phamhungcrab/IT4210/docs/images/4.2.png

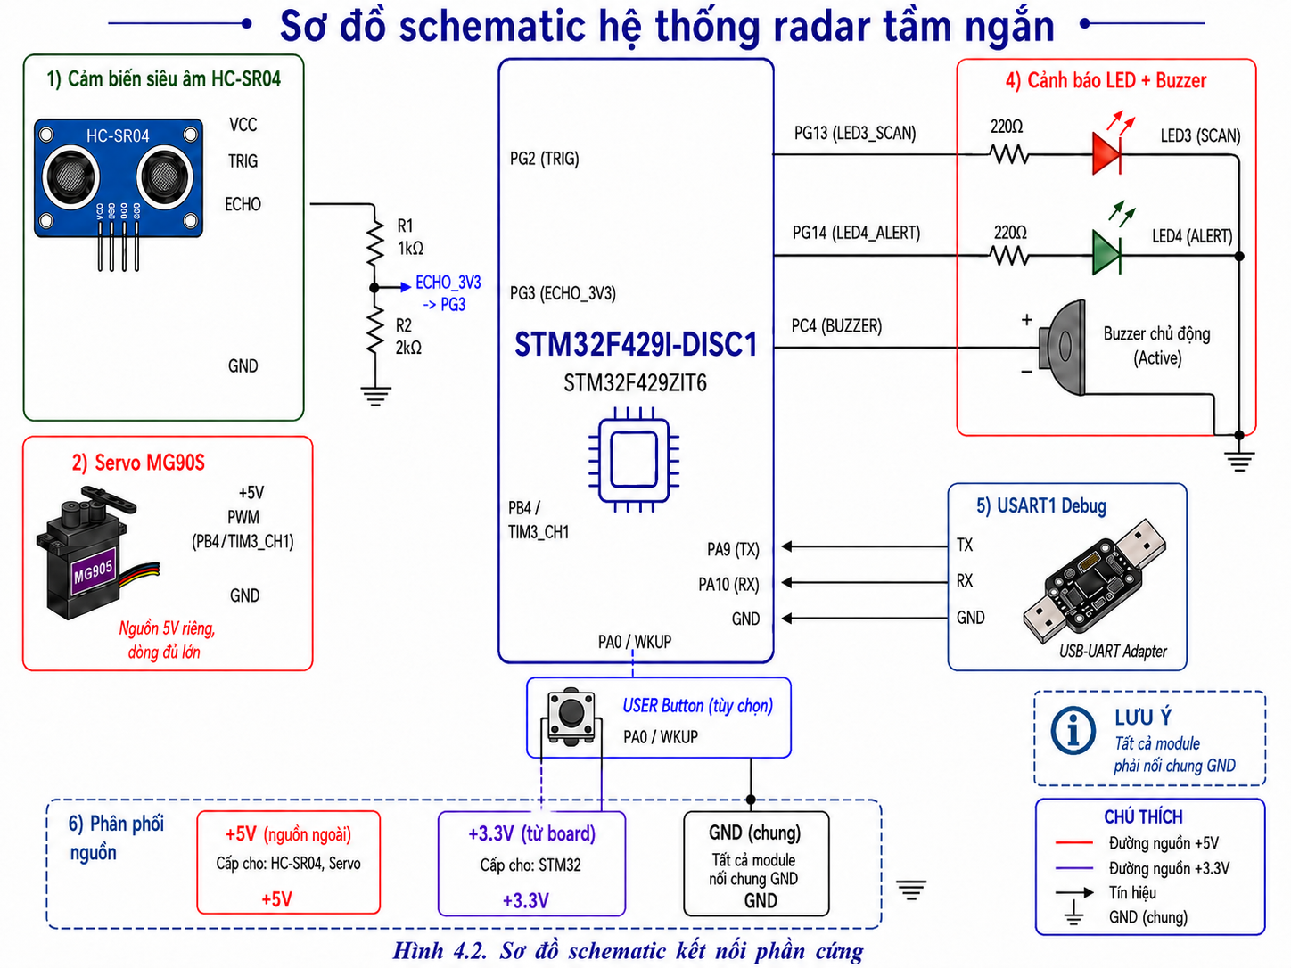
docs/images/4.2.png
