phamhungcrab/IT4210/radar_short_range_touchgfx/Core/Inc/main.h

#define VSYNC_FREQ_Pin GPIO_PIN_2
#define VSYNC_FREQ_GPIO_Port GPIOE
#define RENDER_TIME_Pin GPIO_PIN_3
#define RENDER_TIME_GPIO_Port GPIOE
#define FRAME_RATE_Pin GPIO_PIN_4
#define FRAME_RATE_GPIO_Port GPIOE
#define MCU_ACTIVE_Pin GPIO_PIN_5
#define MCU_ACTIVE_GPIO_Port GPIOE
#define SPI5_NCS_Pin GPIO_PIN_1
#define SPI5_NCS_GPIO_Port GPIOC
#define B1_USER_Pin GPIO_PIN_0
#define B1_USER_GPIO_Port GPIOA
#define HCSR04_TRIG_Pin GPIO_PIN_2
#define HCSR04_TRIG_GPIO_Port GPIOA
#define BUZZER_Pin GPIO_PIN_4
#define BUZZER_GPIO_Port GPIOC
#define LED3_SCAN_Pin GPIO_PIN_13
#define LED3_SCAN_GPIO_Port GPIOG
#define LED4_ALERT_Pin GPIO_PIN_14
#define LED4_ALERT_GPIO_Port GPIOG
