phamhungcrab/IT4210/radar_short_range_touchgfx/STM32CubeIDE/Application/User/buzzer_led.c

#include "buzzer_led.h"
#include "main.h"

/*
 * BUZZER: PC4
 * LED3_SCAN: PG13
 * LED4_ALERT: PG14
 */

void BuzzerLed_Init(void)
{
    Buzzer_Set(0);
    LedScan_Set(0);
    LedAlert_Set(0);
}

void Buzzer_Set(uint8_t on)
{
    HAL_GPIO_WritePin(BUZZER_GPIO_Port,
                      BUZZER_Pin,
                      on ? GPIO_PIN_SET : GPIO_PIN_RESET);
}

void LedScan_Set(uint8_t on)
{
    HAL_GPIO_WritePin(LED3_SCAN_GPIO_Port,
                      LED3_SCAN_Pin,
                      on ? GPIO_PIN_SET : GPIO_PIN_RESET);
}

void LedAlert_Set(uint8_t on)
{
    HAL_GPIO_WritePin(LED4_ALERT_GPIO_Port,
                      LED4_ALERT_Pin,
                      on ? GPIO_PIN_SET : GPIO_PIN_RESET);
}

void Alert_Update(uint8_t detected, uint8_t near_warning)
{
    if (near_warning)
    {
        LedAlert_Set(1);
        Buzzer_Set(1);
    }
    else if (detected)
    {
        LedAlert_Set(1);
        Buzzer_Set(0);
    }
    else
    {
        LedAlert_Set(0);
        Buzzer_Set(0);
    }
}
