phamhungcrab/IT4210/(notices)

Notices in the files:
radar_short_range_touchgfx/Core/Inc/main.h:
© Copyright (c) 2020 STMicroelectronics.
All rights reserved.
This software component is licensed by ST under Ultimate Liberty license
